elekras/fs6809sbc/README.md

# fs6809sbc
A simple 6809 single board computer under 
Open Source Hardware (OSHW) Definition 1.0
https://www.oshwa.org/definition/
by Fabio Sturman (c) 2024 fabio.sturman@gmail.com
