elekras/fs6809sbc/fs6809sbc.kicad_pcb

## KiCad design fs6809sbc.kicad_pcb (2024-08-10)

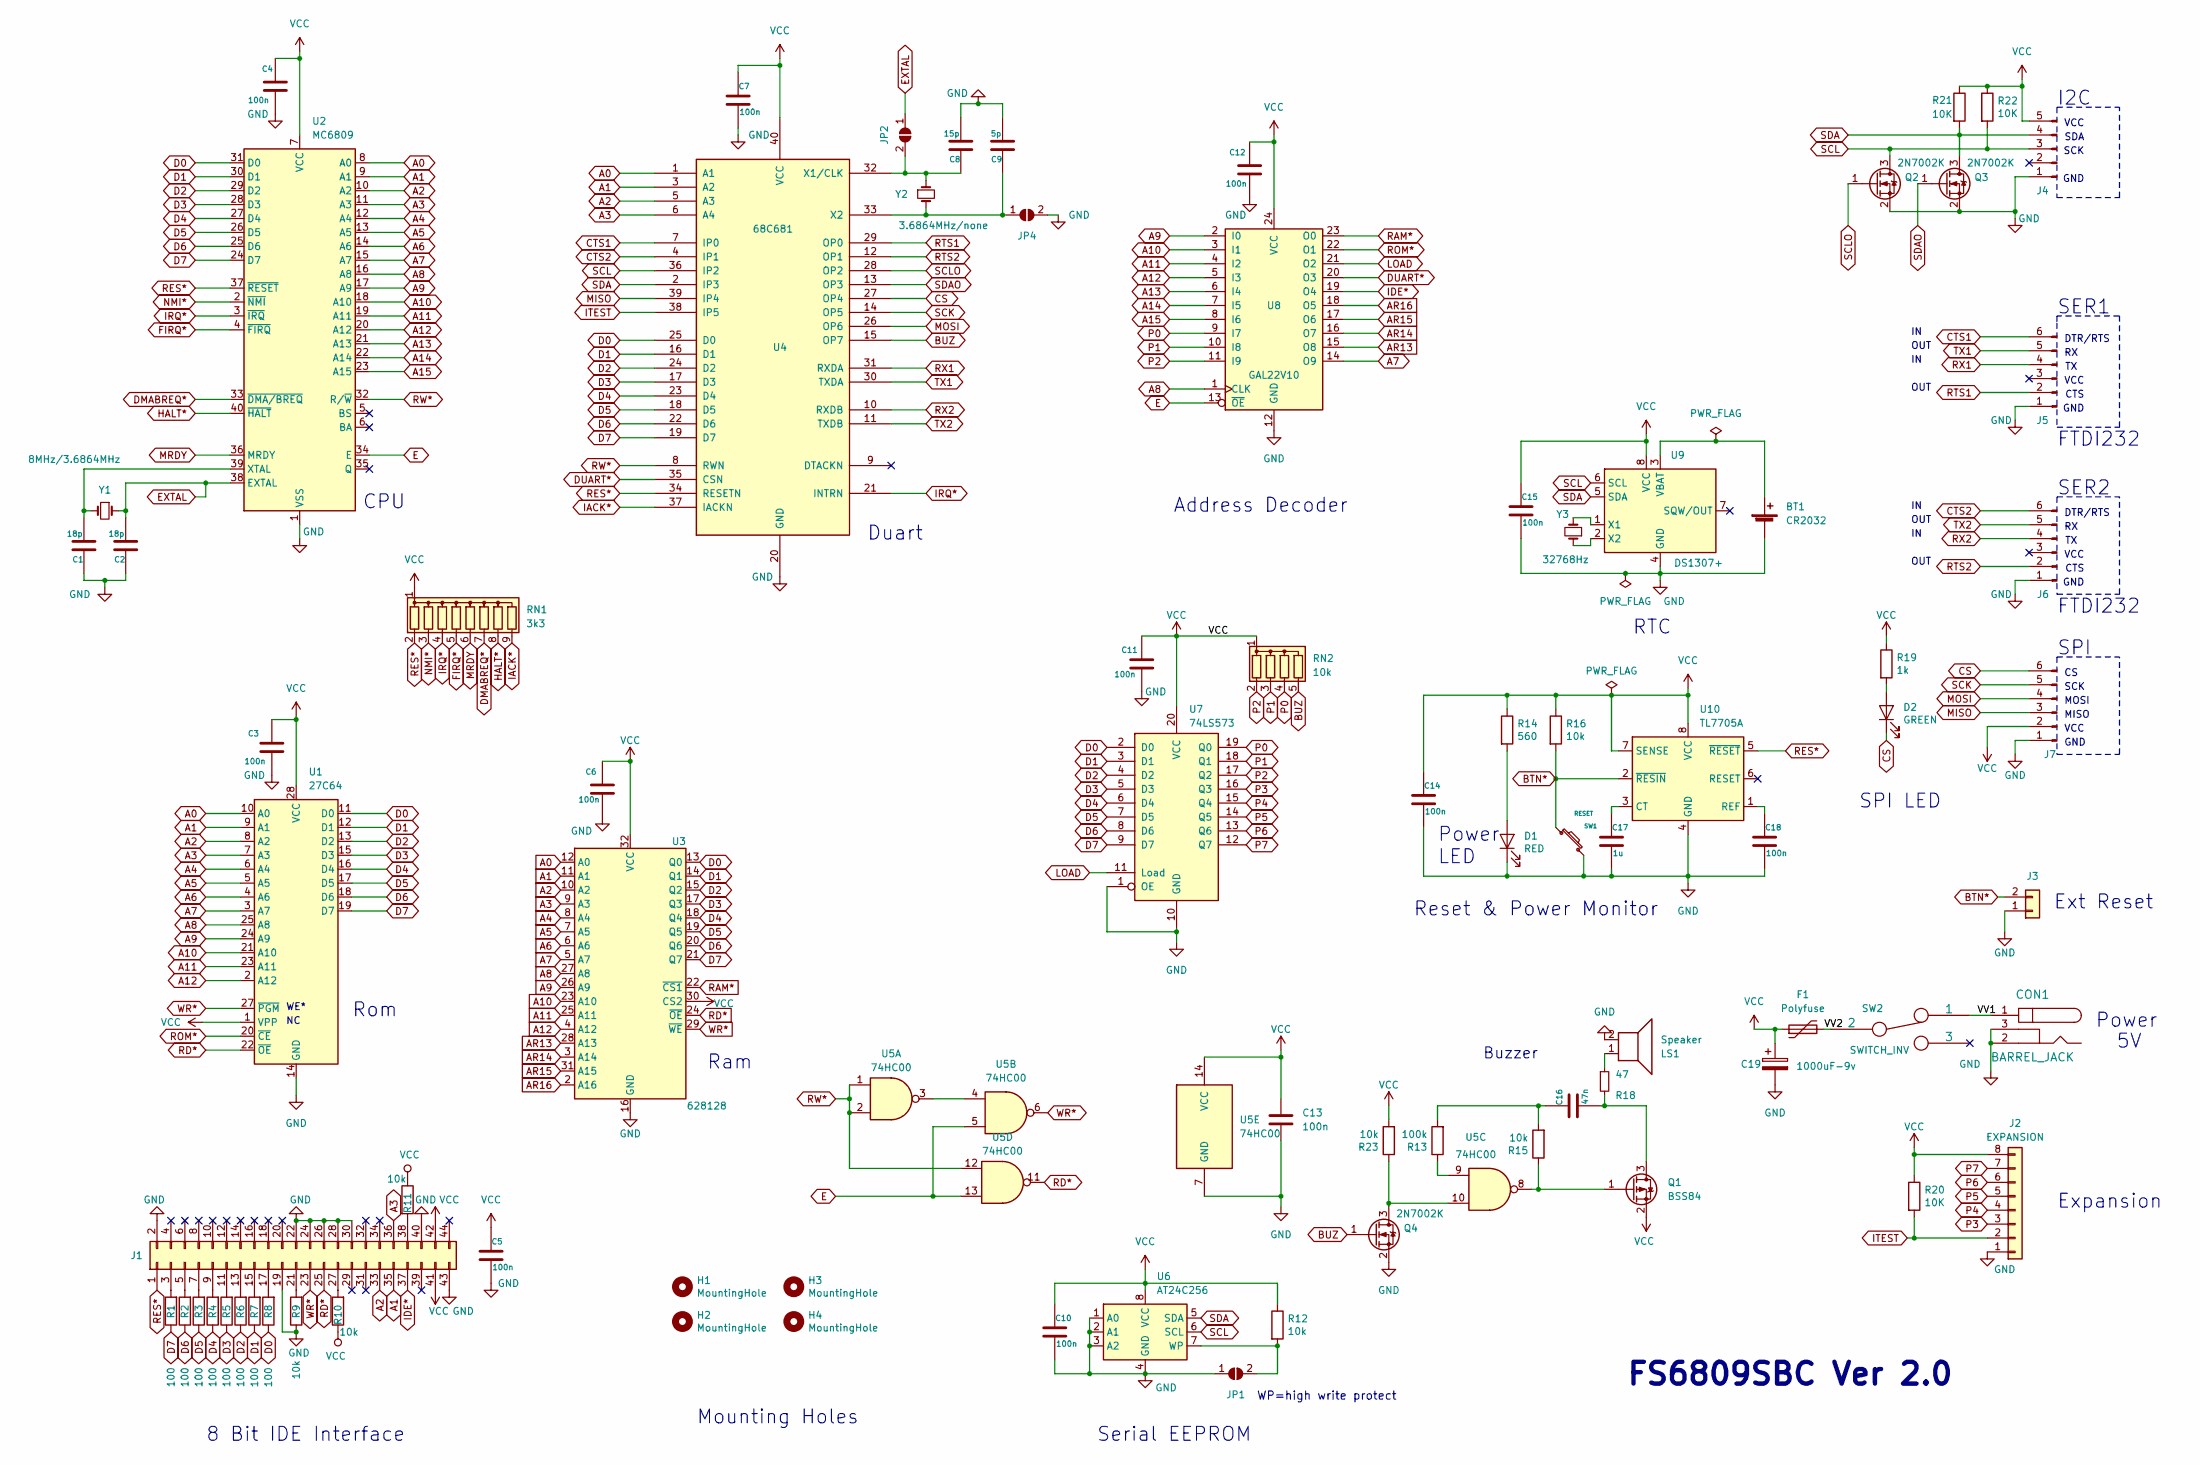
[picture p1: schematic fs6809sbc.kicad_sch]

Parts:
BT1: CR2032; Battery_CR2032-HFN_Horizontal_CircularHoles
C1, C2: 18p; C_0805_2012Metric_Pad1.18x1.45mm_HandSolder
C3, C4, C5, C6, C7, C10, C11, C12, C13, C14, C15, C18: 100n; C_0805_2012Metric_Pad1.18x1.45mm_HandSolder
C8: 15p; C_0805_2012Metric_Pad1.18x1.45mm_HandSolder
C9: 5p; C_0805_2012Metric_Pad1.18x1.45mm_HandSolder
C16: 47n; C_0805_2012Metric_Pad1.18x1.45mm_HandSolder
C17: 1u; C_0805_2012Metric_Pad1.18x1.45mm_HandSolder
C19: 1000uF-9v; CP_Radial_D8.0mm_P2.50mm
CON1: BARREL_JACK; BarrelJack_Wuerth_6941xx301002
D1: RED; LED_0805_2012Metric_Pad1.15x1.40mm_HandSolder
D2: GREEN; LED_0805_2012Metric_Pad1.15x1.40mm_HandSolder
F1: Polyfuse; D_SMB_Handsoldering
H1, H2, H3, H4: MountingHole; MountingHole_3.5mm_Pad
J1: Conn_02x22_Odd_Even; Edge_2x22_P2.00mm_SMD
J2: EXPANSION; PinHeader_1x08_P2.54mm_Vertical
J3: RESET; PinHeader_1x02_P2.54mm_Vertical
J4: I2C; PinHeader_1x05_P2.54mm_Vertical
J5: SER1; PinHeader_1x06_P2.54mm_Vertical
J6: SER2; PinHeader_1x06_P2.54mm_Vertical
J7: SPI; PinHeader_1x06_P2.54mm_Vertical
JP1, JP2, JP4: SolderJumper_2_Open; SolderJumper-2_P1.3mm_Open_RoundedPad1.0x1.5mm
LS1: Speaker; Buzzer_12x9.5RM6.5
Q1: BSS84; SOT-23_Handsoldering
Q2, Q3, Q4: 2N7002K; SOT-23_Handsoldering
R1, R2, R3, R4, R5, R6, R7, R8: 100; R_0805_2012Metric_Pad1.20x1.40mm_HandSolder
R9, R10, R11, R12, R15, R16, R23: 10k; R_0805_2012Metric_Pad1.20x1.40mm_HandSolder
R13: 100k; R_0805_2012Metric_Pad1.20x1.40mm_HandSolder
R14: 560; R_0805_2012Metric_Pad1.20x1.40mm_HandSolder
R18: 47; R_0805_2012Metric_Pad1.20x1.40mm_HandSolder
R19: 1k; R_0805_2012Metric_Pad1.20x1.40mm_HandSolder
R20, R21, R22: 10K; R_0805_2012Metric_Pad1.20x1.40mm_HandSolder
RN1: 3k3; R_Array_SIP9
RN2: 10k; R_Array_SIP5
SW1: RESET; SW_PUSH_6mm_H4.3mm
SW2: SWITCH_INV; PinHeader_1x03_P2.54mm_Vertical
U1: 27C64; DIP-28_W15.24mm_Socket_LongPads
U2: MC6809; DIP-40_W15.24mm_Socket_LongPads
U3: 628128; DIP-32_W15.24mm_Socket_LongPads
U4: 68C681; DIP-40_W15.24mm_Socket_LongPads
U5: 74HC00; DIP-14_W7.62mm_Socket_LongPads
U6: AT24C256; DIP-8_W7.62mm_Socket_LongPads
U7: 74LS573; DIP-20_W7.62mm_Socket_LongPads
U8: GAL22V10; DIP-24_W7.62mm_Socket_LongPads
U9: DS1307+; DIP-8_W7.62mm_Socket_LongPads
U10: TL7705A; DIP-8_W7.62mm_Socket_LongPads
Y1: 8MHz/3.6864MHz; Crystal_HC49-U_Vertical
Y2: 3.6864MHz/none; Crystal_HC49-U_Vertical
Y3: 32768Hz; Crystal_AT310_D3.0mm_L10.0mm_Horizontal

Connections:
/VV1: CON1.1, SW2.1
/VV2: F1.2, SW2.2
A0: U1.10 (A0), U2.8 (A0), U3.12 (A0), U4.1 (A1)
A1: J1.35, U1.9 (A1), U2.9 (A1), U3.11 (A1), U4.3 (A2)
A2: J1.33, U1.8 (A2), U2.10 (A2), U3.10 (A2), U4.5 (A3)
A3: J1.36, U1.7 (A3), U2.11 (A3), U3.9 (A3), U4.6 (A4)
A4: U1.6 (A4), U2.12 (A4), U3.8 (A4)
A5: U1.5 (A5), U2.13 (A5), U3.7 (A5)
A6: U1.4 (A6), U2.14 (A6), U3.6 (A6)
A7: U1.3 (A7), U2.15 (A7), U3.5 (A7), U8.14 (O9)
A8: U1.25 (A8), U2.16 (A8), U3.27 (A8), U8.1 (CLK)
A9: U1.24 (A9), U2.17 (A9), U3.26 (A9), U8.2 (I0)
A10: U1.21 (A10), U2.18 (A10), U3.23 (A10), U8.3 (I1)
A11: U1.23 (A11), U2.19 (A11), U3.25 (A11), U8.4 (I2)
A12: U1.2 (A12), U2.20 (A12), U3.4 (A12), U8.5 (I3)
A13: U2.21 (A13), U8.6 (I4)
A14: U2.22 (A14), U8.7 (I5)
A15: U2.23 (A15), U8.8 (I6)
AR13: U3.28 (A13), U8.15 (O8)
AR14: U3.3 (A14), U8.16 (O7)
AR15: U3.31 (A15), U8.17 (O6)
AR16: U3.2 (A16), U8.18 (O5)
BTN*: J3.2, R16.2, SW1.1, U10.2 (~RESIN)
BUZ: Q4.1 (G), RN2.5 (R4), U4.15 (OP7)
CS: D2.1 (K), J7.6, U4.27 (OP4)
CTS1: J5.6, U4.7 (IP0)
CTS2: J6.6, U4.4 (IP1)
D0: R8.1, U1.11 (D0), U2.31 (D0), U3.13 (Q0), U4.25 (D0), U7.2 (D0)
D1: R7.1, U1.12 (D1), U2.30 (D1), U3.14 (Q1), U4.16 (D1), U7.3 (D1)
D2: R6.1, U1.13 (D2), U2.29 (D2), U3.15 (Q2), U4.24 (D2), U7.4 (D2)
D3: R5.1, U1.15 (D3), U2.28 (D3), U3.17 (Q3), U4.17 (D3), U7.5 (D3)
D4: R4.1, U1.16 (D4), U2.27 (D4), U3.18 (Q4), U4.23 (D4), U7.6 (D4)
D5: R3.1, U1.17 (D5), U2.26 (D5), U3.19 (Q5), U4.18 (D5), U7.7 (D5)
D6: R2.1, U1.18 (D6), U2.25 (D6), U3.20 (Q6), U4.22 (D6), U7.8 (D6)
D7: R1.1, U1.19 (D7), U2.24 (D7), U3.21 (Q7), U4.19 (D7), U7.9 (D7)
DMABREQ*: RN1.7 (R6), U2.33 (~DMA/BREQ)
DUART*: U4.35 (CSN), U8.20 (O3)
E: U2.34 (E), U5.5, U5.13, U8.13 (~OE)
EXTAL: C2.2, JP2.1 (A), U2.38 (EXTAL), Y1.1
FIRQ*: RN1.5 (R4), U2.4 (~FIRQ)
GND: BT1.2 (-), C1.1, C2.1, C3.2, C4.2, C5.2, C6.2, C7.2, C8.2, C9.2, C10.2, C11.2, C12.2, C13.2, C14.2, C15.2, C17.2, C18.2, C19.2, CON1.2, CON1.3, D1.1 (K), J1.2, J1.19, J1.22, J1.24, J1.26, J1.28, J1.30, J1.40, J1.43, J2.1, J3.1, J4.1, J5.1, J6.1, J7.1, JP1.1 (A), JP4.2 (B), LS1.2, Q2.2 (S), Q3.2 (S), Q4.2 (S), R9.1, SW1.2, U1.14 (GND), U2.1 (VSS), U3.16 (GND), U4.20 (GND), U5.7 (GND), U6.1 (A0), U6.2 (A1), U6.3 (A2), U6.4 (GND), U7.1 (OE), U7.10 (GND), U8.12 (GND), U9.4 (GND), U10.4 (GND)
HALT*: RN1.8 (R7), U2.40 (~HALT)
IACK*: RN1.9 (R8), U4.37 (IACKN)
IDE*: J1.37, U8.19 (O4)
IRQ*: RN1.4 (R3), U2.3 (~IRQ), U4.21 (INTRN)
ITEST: J2.2, R20.2, U4.38 (IP5)
LOAD: U7.11 (Load), U8.21 (O2)
MISO: J7.3, U4.39 (IP4)
MOSI: J7.4, U4.26 (OP6)
MRDY: RN1.6 (R5), U2.36 (MRDY)
NMI*: RN1.3 (R2), U2.2 (~NMI)
unnamed: BT1.1 (+), U9.3 (VBAT)
unnamed: C16.1, R13.2, R15.2
unnamed: D1.2 (A), R14.2
unnamed: D2.2 (A), R19.2
unnamed: J1.3, R1.2
unnamed: J1.5, R2.2
unnamed: J1.7, R3.2
unnamed: J1.9, R4.2
unnamed: J1.11, R5.2
unnamed: J1.13, R6.2
unnamed: J1.15, R7.2
unnamed: J1.17, R8.2
unnamed: J1.21, R9.2
unnamed: J1.27, R10.2
unnamed: J1.38, R11.2
unnamed: JP1.2 (B), R12.2, U6.7 (WP)
unnamed: C8.1, JP2.2 (B), U4.32 (X1/CLK), Y2.1
unnamed: C9.1, JP4.1 (A), U4.33 (X2), Y2.2
unnamed: LS1.1, R18.1
unnamed: C16.2, Q1.3 (D), R18.2
unnamed: Q1.1 (G), R15.1, U5.8
unnamed: Q4.3 (D), R23.1, U5.10
unnamed: R13.1, U5.9
unnamed: C1.2, U2.39 (XTAL), Y1.2
unnamed: U5.3, U5.4
unnamed: U9.1 (X1), Y3.2
unnamed: U9.2 (X2), Y3.1
unnamed: C17.1, U10.3 (CT)
unnamed: C18.1, U10.1 (REF)
P0: RN2.4 (R3), U7.19 (Q0), U8.9 (I7)
P1: RN2.3 (R2), U7.18 (Q1), U8.10 (I8)
P2: RN2.2 (R1), U7.17 (Q2), U8.11 (I9)
P3: J2.3, U7.16 (Q3)
P4: J2.4, U7.15 (Q4)
P5: J2.5, U7.14 (Q5)
P6: J2.6, U7.13 (Q6)
P7: J2.7, U7.12 (Q7)
RAM*: U3.22 (~CS1), U8.23 (O0)
RD*: J1.25, U1.22 (~OE), U3.24 (~OE), U5.11
RES*: J1.1, RN1.2 (R1), U2.37 (~RESET), U4.34 (RESETN), U10.5 (~RESET)
ROM*: U1.20 (~CE), U8.22 (O1)
RTS1: J5.2, U4.29 (OP0)
RTS2: J6.2, U4.12 (OP1)
RW*: U2.32 (R/~W), U4.8 (RWN), U5.1, U5.2, U5.12
RX1: J5.4, U4.31 (RXDA)
RX2: J6.4, U4.10 (RXDB)
SCK: J7.5, U4.14 (OP5)
SCL: J4.3, Q2.3 (D), R22.2, U4.36 (IP2), U6.6 (SCL), U9.6 (SCL)
SCLO: Q2.1 (G), U4.28 (OP2)
SDA: J4.4, Q3.3 (D), R21.2, U4.2 (IP3), U6.5 (SDA), U9.5 (SDA)
SDAO: Q3.1 (G), U4.13 (OP3)
TX1: J5.5, U4.30 (TXDA)
TX2: J6.5, U4.11 (TXDB)
VCC: C3.1, C4.1, C5.1, C6.1, C7.1, C10.1, C11.1, C12.1, C13.1, C14.1, C15.1, C19.1, F1.1, J1.41, J1.42, J2.8, J4.5, J7.2, Q1.2 (S), R10.1, R11.1, R12.1, R14.1, R16.1, R19.1, R20.1, R21.1, R22.1, R23.2, RN1.1 (common), RN2.1 (common), U1.1 (VPP), U1.28 (VCC), U2.7 (VCC), U3.30 (CS2), U3.32 (VCC), U4.40 (VCC), U5.14 (VCC), U6.8 (VCC), U7.20 (VCC), U8.24 (VCC), U9.8 (VCC), U10.7 (SENSE), U10.8 (VCC)
WR*: J1.23, U1.27 (~PGM), U3.29 (~WE), U5.6

Notes on the sheet:
Duart
CTS
Ext Reset
VCC
OUT
GND
Reset & Power Monitor
CPU
I2C
Buzzer
MOSI
SCK
Mounting Holes
Expansion
Ram
Address Decoder
SDA
DTR/RTS
SER2
Power LED
Serial EEPROM
MISO
SPI LED
Rom
8 Bit IDE Interface
WP=high write protect
Power
WE*
FTDI232
SER1
SPI
FS6809SBC Ver 2.0
RTC

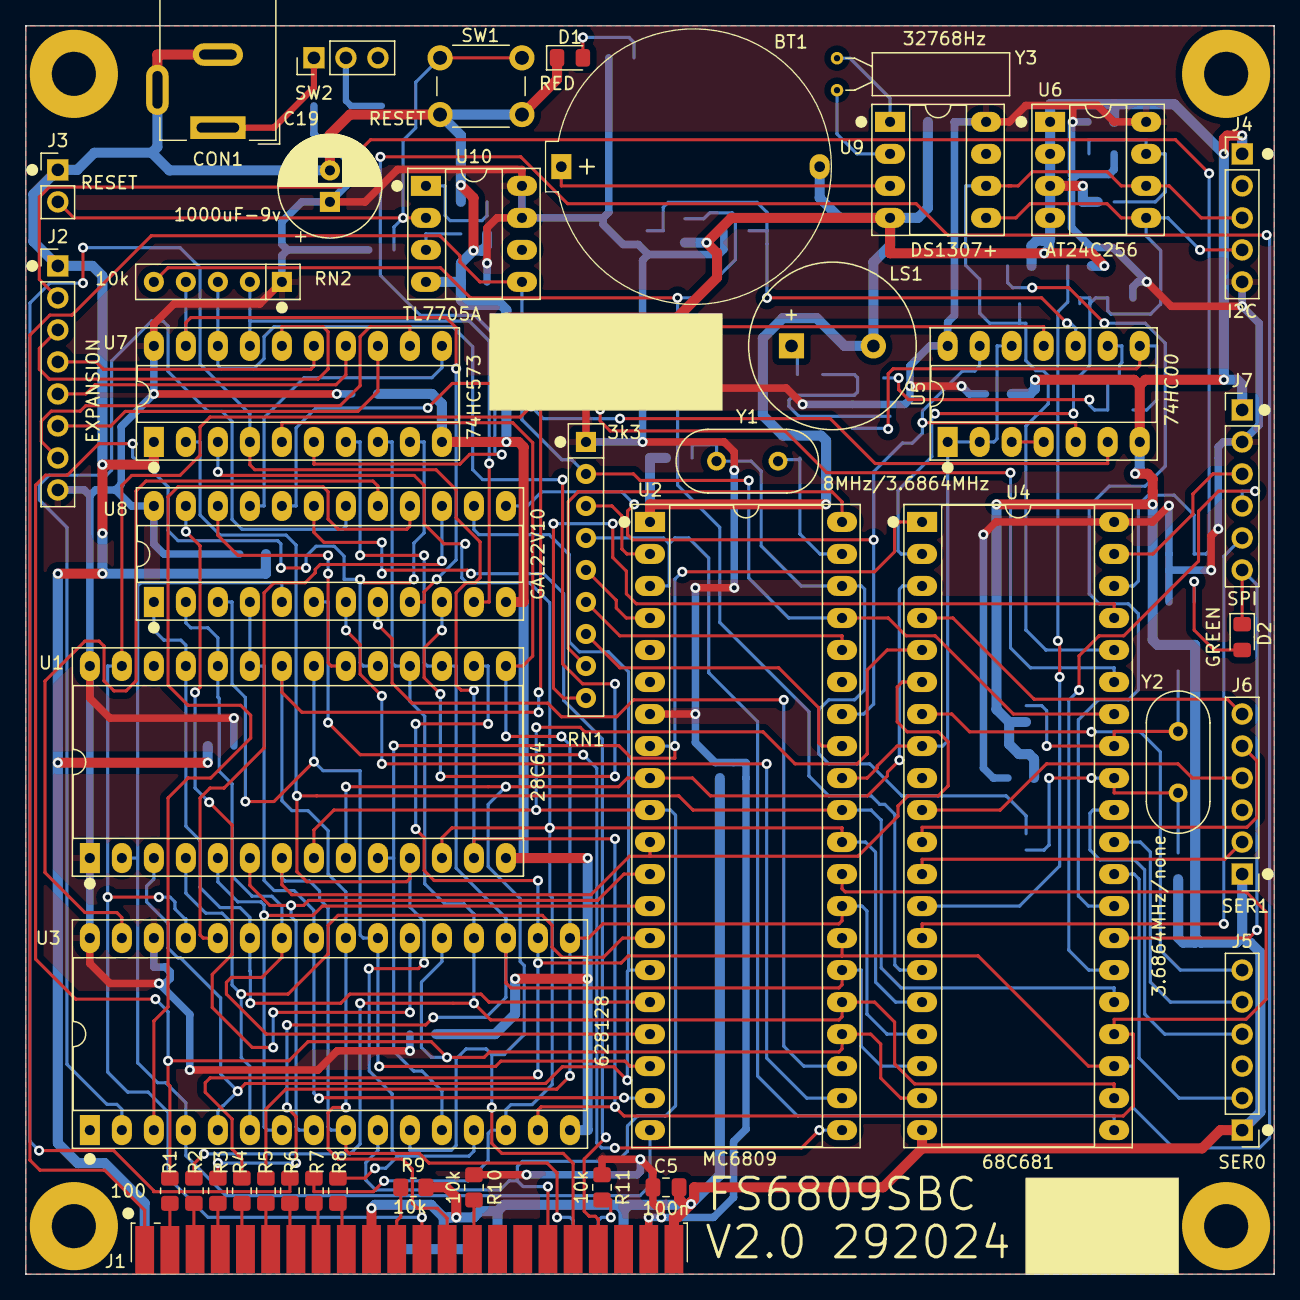
[picture p2: board fs6809sbc.kicad_pcb from above]

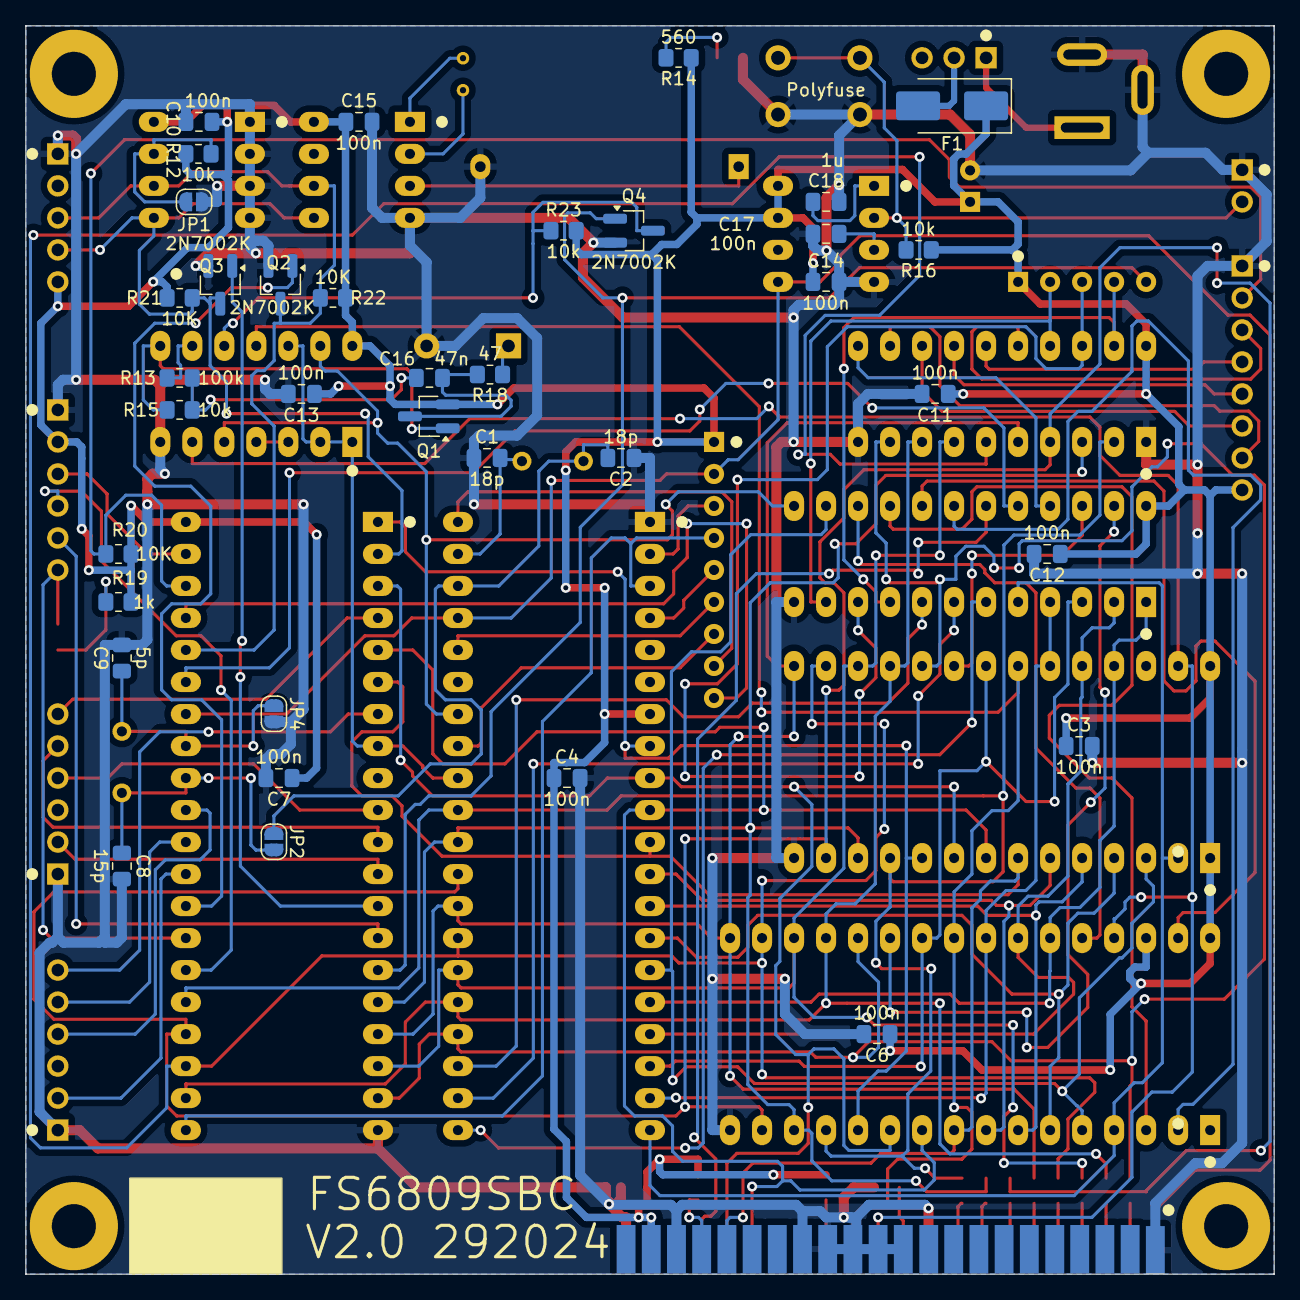
[picture p3: board fs6809sbc.kicad_pcb from below]

Board: 2 copper layers, 99.1 x 99.1 mm, 82 parts (36 on the bottom side), 106 nets.
