elekras/fs6809sbc/(threads)

Thread 2 (2025-06-22):

GALasm equvalent file of the CUPL pld file

cardassian, 2025-06-22:
GAL source file in CUPL, if you prefer (complete) open source workflow, here is the equivalent file in GALASM

-x-x-x-
GAL22V10
fs6809sb

A8 A9   A10  A11  A12  A13  A14  A15    P0  P1   P2   GND
E  A7   AR13 AR14 AR15 AR16 IDE  DUART  PMU ROM  RAM  VCC

/IDE =   E * A15 * A14 * A13 * A12 * /A11 * /A10 * /A9 *   /A8 * /A7;
/DUART = E * A15 * A14 * A13 * A12 * /A11 * /A10 * /A9 *   /A8 *  A7;
PMU =    E * A15 * A14 * A13 * A12 * /A11 * /A10 * /A9 *    A8 * /A7;

/ROM =   E * A15 * A14 * A13 * A12 * A11 +
         E * A15 * A14 * A13 * A12 * /A11 * A10;

/RAM =   E * /A15  +
         E * A15 * /A14  +
         E * A15 * A14 * /A13  +
         E * A15 * A14 * A13 * /A12 +
         E * A15 * A14 * A13 * A12 * /A11 * /A10 *  A9 +
         E * A15 * A14 * A13 * A12 * /A11 * /A10 * /A9 * A8 * A7 ;

AR16 =   A15 * /A14 * A13;

AR15 =   A15 * A14  +
         A15 * /A13  +
	 A15 * /A14 * A13 * P2;

AR14 =   A14 +
	 A15 * /A14 * A13 * P1;

AR13 =   /A15 *A13  +
         A14 * A13   +
	 A15 * /A14 * A13 * P0;

DESCRIPTION

https://github.com/daveho/GALasm
galasm <file>

   	ram:    0000/60KiB
	page:   A000/8KibB
   	ide:    F000/128
   	duart:  F080/128
   	pmu:    F100/128   paged memory unit latch
	free:   F180/128   ram
        ram1:   F200/512   ram
	rom:    F400/3KiB

Name     fs6809sbc;
PartNo   01 ;
Date     09/06/2024;
Revision 11;
Designer Fabio Sturman;
Company  Elekras;
Assembly fs6809sbc;
Location U8;
Device   g22v10;

	ADDRESS DECODER
	PAGED MEMORY DECODER
	FOR FS6809SBC
	(c) 2024 by Fabio Sturman  fabio.sturman@gmail.com
	Version 1.0 - 08.06.2024
	Version 1.1 - 09.07.2024
x-x-x-x-x
